Irfan122004/BTP_IIITDMK/extemp - Copy.png

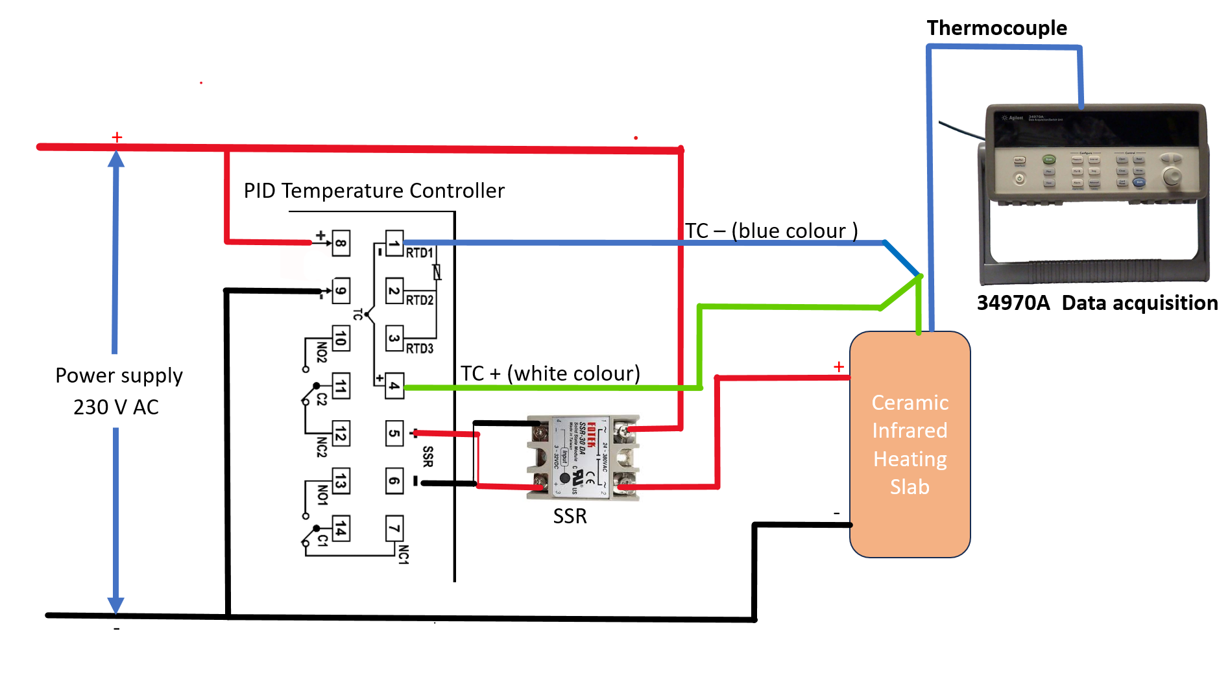
extemp - Copy.png
