Irfan122004/BTP_IIITDMK/manual temp data.png

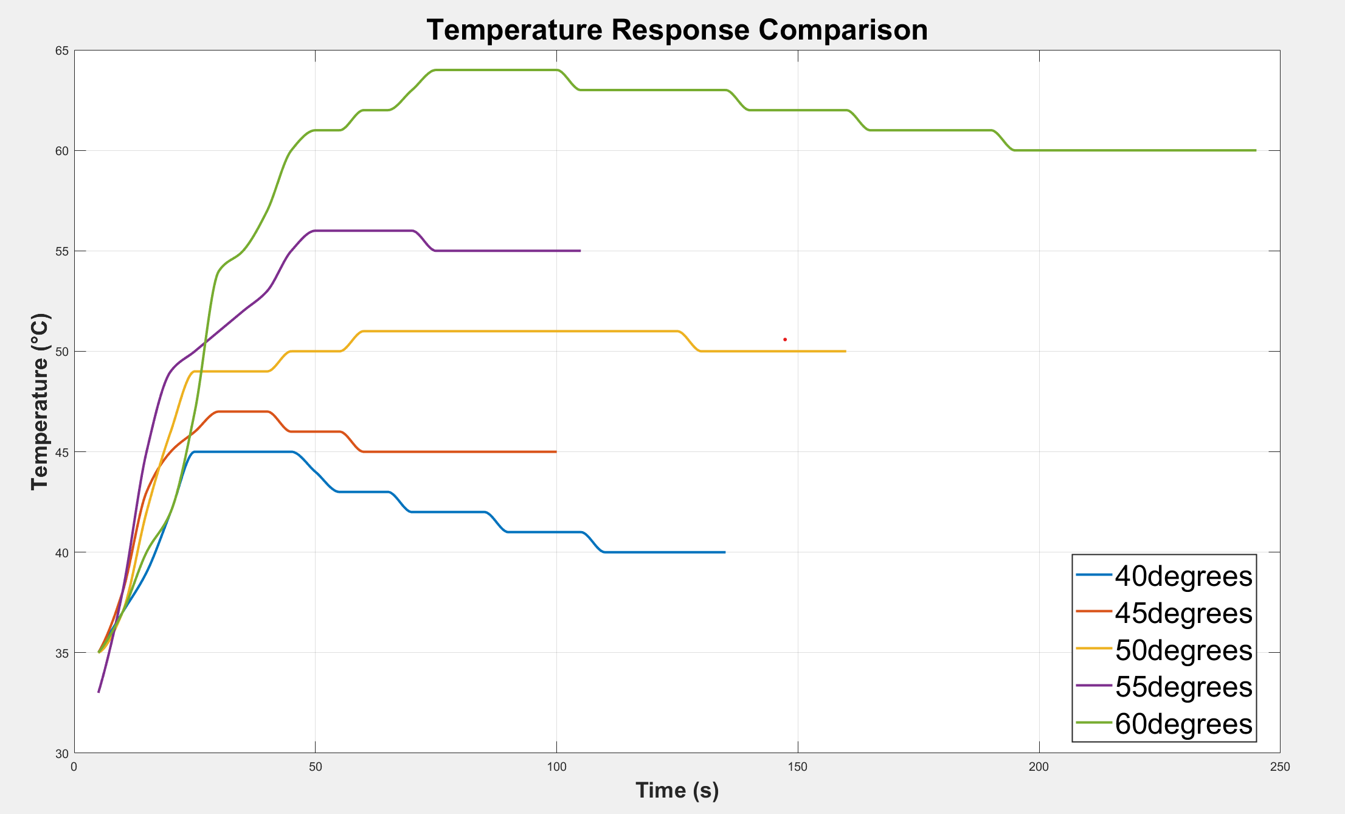
manual temp data.png
